Floche/domodin/README.md

# domodin
Extension fil pilote sur rail DIN pour Raspberry Pi

https://domodin.wordpress.com/
