Floche/domodin/hardware/DomoDinV1.0.brd

## EAGLE design hardware/DomoDinV1.0.brd (2015-09-30)

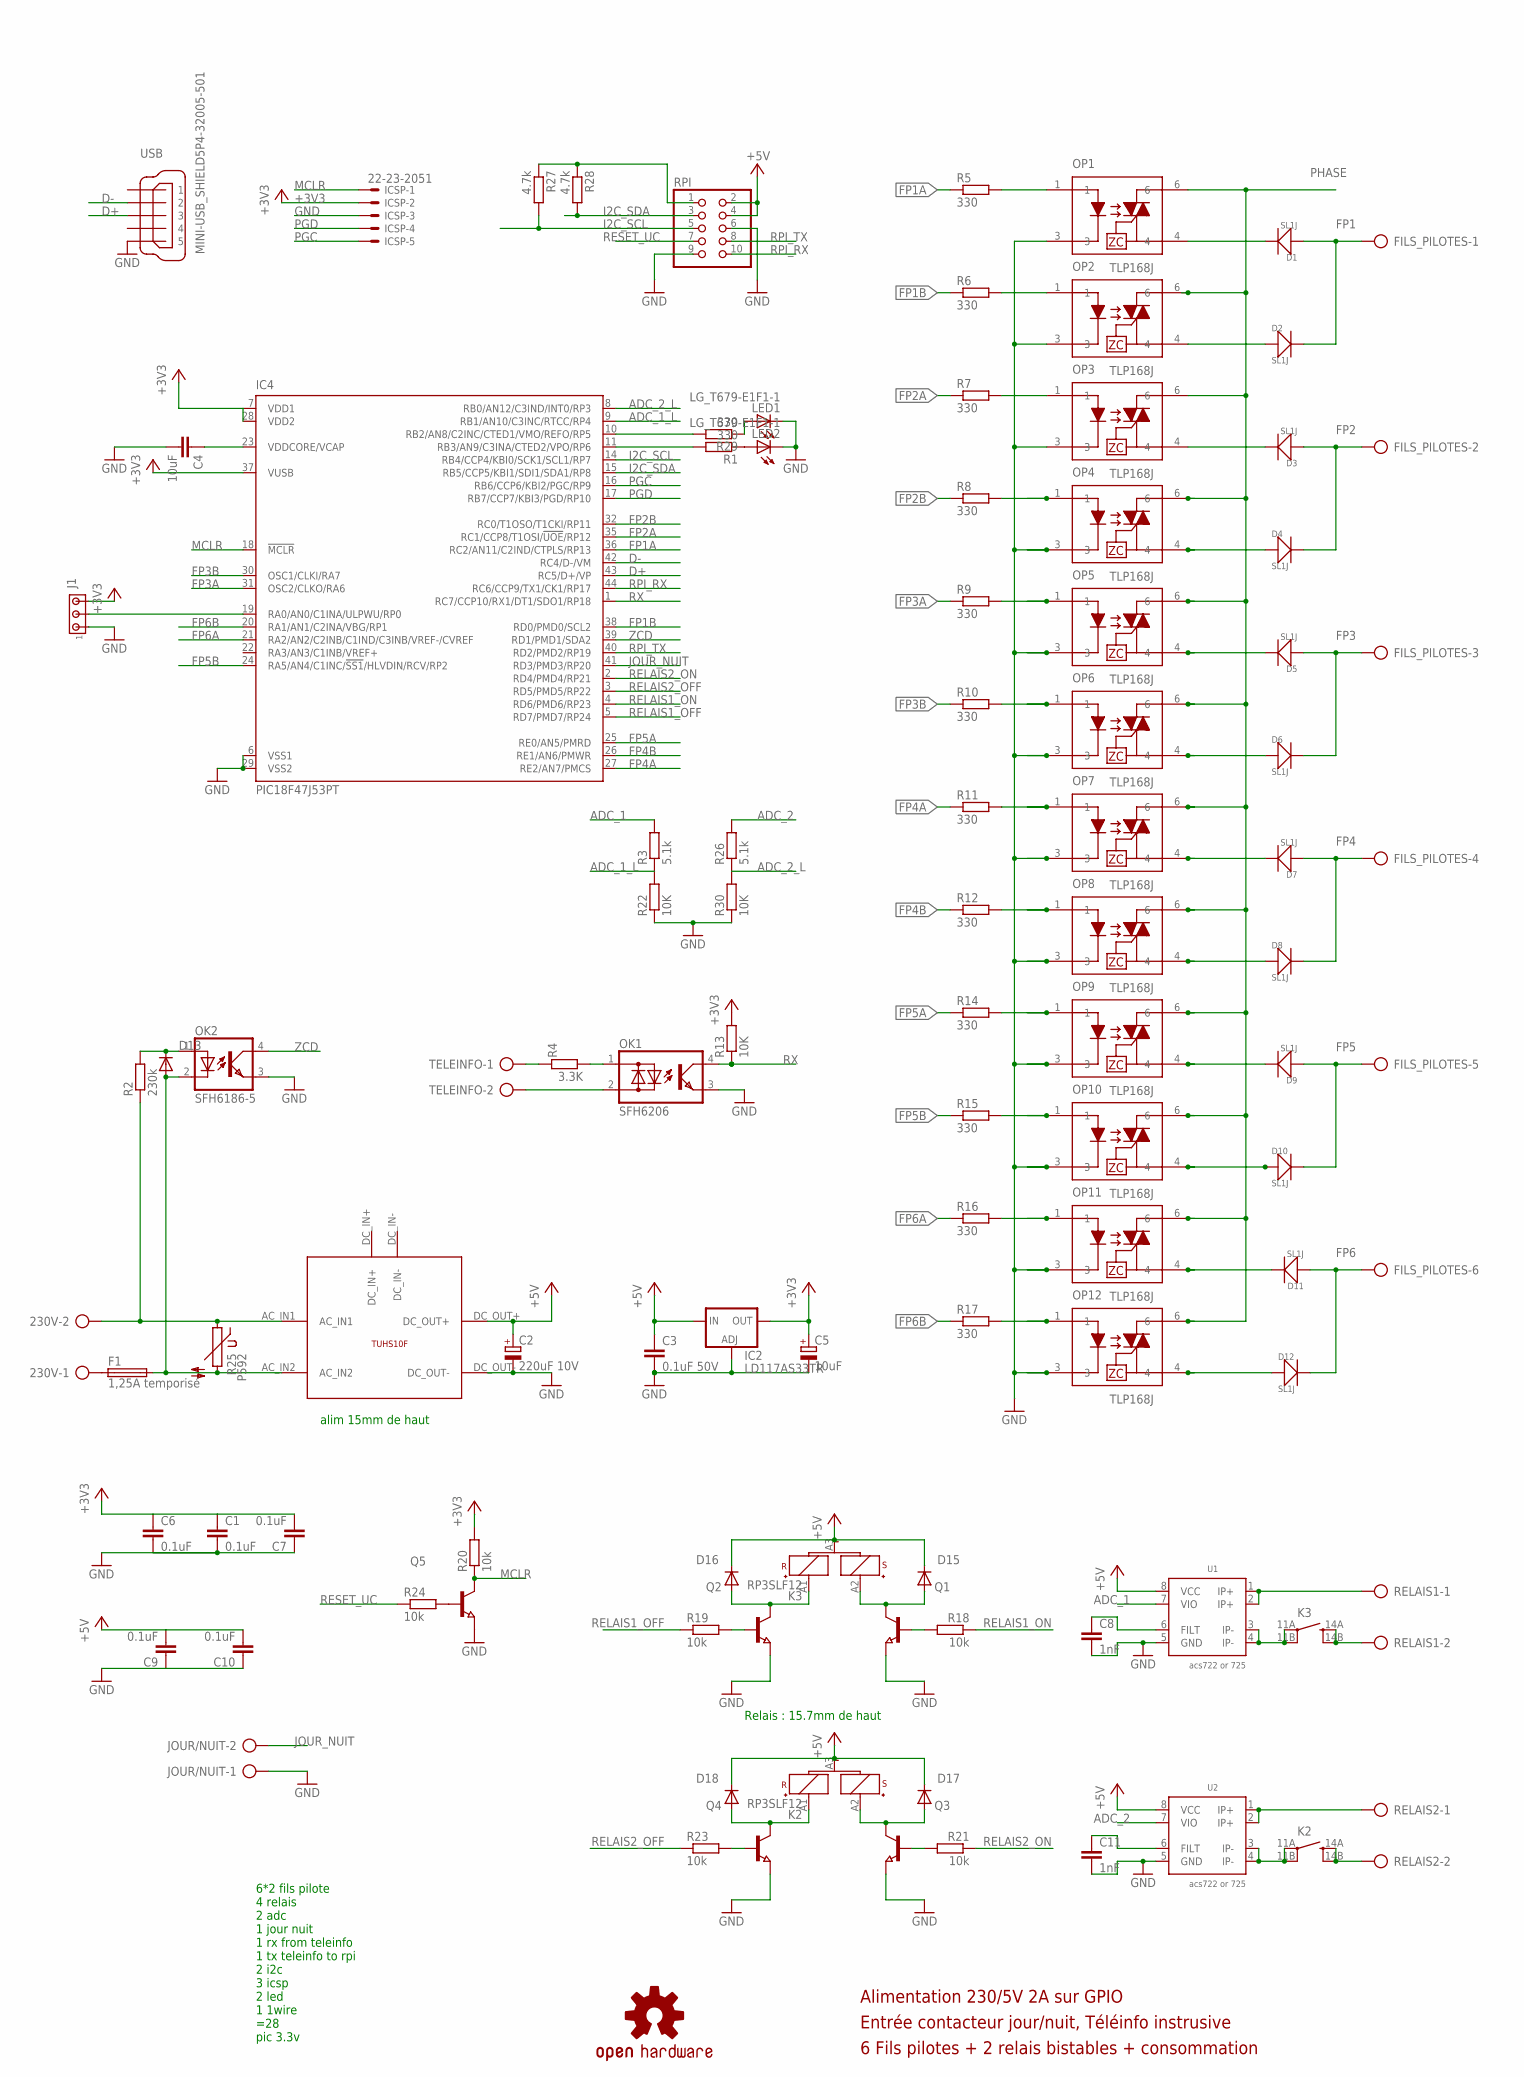
[picture p1: schematic DomoDinV1.0.sch]

Parts:
230V: AK500/2
C1, C6, C7, C9, C10: 0.1uF; C0603
C2: 220uF 10V; E5-8,5
C3: 0.1uF 50V; C1206
C4: 10uF; C1210K
C5: 10uF; C/6032-28R
C8, C11: 1nF; C0402
D1, D2, D3, D4, D5, D6, D7, D8, D9, D10, D11, D12: SL1J; DO-214AC
D13, D15, D16, D17, D18: CGRM4001-G; SOD-123_MINI-SMA
F1: 1,25A temporisé; TE5
FILS_PILOTES: AK500/6
IC2: LD117AS33TR; SOT223
IC4: PIC18F47J53PT; TQFP44
ICSP: 22-23-2051
J1: MTA03-100; 10X03MTA
JOUR/NUIT: AK500/2
K2, K3: RP3SLF12; RP-SLF
LED1, LED2: LG_T679-E1F1-1; PLCC2
LOGO1: OSHW-LOGOL; OSHW-LOGO-L
OK1: SFH6206; DIL4-SMD
OK2: SFH6186-5; SMD4-7
OP1, OP2, OP3, OP4, OP5, OP6, OP7, OP8, OP9, OP10, OP11, OP12: TLP168J; MFSOP-4-HANDSOLDER
Q1, Q2, Q3, Q4, Q5: NPN-TRANSISTOR_SOT23; SOT23
R1, R5, R6, R7, R8, R9, R10, R11, R12, R14, R15, R16, R17, R29: 330; R0805
R2: 230k; 0204/7
R3, R26: 5.1k; R0402
R4: 3.3K; R0805
R13: 10K; R0805
R18, R19, R20, R21, R23, R24: 10k; R0805
R22, R30: 10K; R0402
R25: P592
R27, R28: 4.7k; R0805
RELAIS1, RELAIS2: AK500/2
RPI: PINHD-2X5; 2X05
TELEINFO: AK500/2
U1, U2: acs722 or 725; SO08
U$1: TUHS10F; TUHS10F05
USB: MINI-USB_SHIELD5P4-32005-501; 32005-501

Connections:
+3V3: C1.1, C5.+, C6.1, C7.2, IC2.4 (OUT), IC4.7 (VDD1), IC4.28 (VDD2), IC4.37 (VUSB), ICSP.2, J1.3, R13.2, R20.2
+5V: C2.+, C3.1, C9.2, C10.2, D15.C, D16.C, D17.C, D18.C, IC2.3 (IN), K2.A3 (-), K3.A3 (-), RPI.2, RPI.4, U1.8 (VCC), U2.8 (VCC), U$1.DC_OUT+
ADC_1: R3.2, U1.7 (VIO)
ADC_1_L: IC4.9 (RB1/AN10/C3INC/RTCC/RP4), R3.1, R22.2
ADC_2: R26.2, U2.7 (VIO)
ADC_2_L: IC4.8 (RB0/AN12/C3IND/INT0/RP3), R26.1, R30.2
D+: IC4.43 (RC5/D+/VP), USB.3
D-: IC4.42 (RC4/D-/VM), USB.2
FP1: D1.1 (+), D2.2 (-), FILS_PILOTES.1
FP1A: IC4.36 (RC2/AN11/C2IND/CTPLS/RP13), R5.1
FP1B: IC4.38 (RD0/PMD0/SCL2), R6.1
FP2: D3.1 (+), D4.2 (-), FILS_PILOTES.2
FP2A: IC4.35 (RC1/CCP8/T1OSI/!UOE!/RP12), R7.1
FP2B: IC4.32 (RC0/T1OSO/T1CKI/RP11), R8.1
FP3: D5.1 (+), D6.2 (-), FILS_PILOTES.3
FP3A: IC4.31 (OSC2/CLKO/RA6), R9.1
FP3B: IC4.30 (OSC1/CLKI/RA7), R10.1
FP4: D7.1 (+), D8.2 (-), FILS_PILOTES.4
FP4A: IC4.27 (RE2/AN7/PMCS), R11.1
FP4B: IC4.26 (RE1/AN6/PMWR), R12.1
FP5: D9.1 (+), D10.2 (-), FILS_PILOTES.5
FP5A: IC4.25 (RE0/AN5/PMRD), R14.1
FP5B: IC4.24 (RA5/AN4/C1INC/!SS1!/HLVDIN/RCV/RP2), R15.1
FP6: D11.1 (+), D12.2 (-), FILS_PILOTES.6
FP6A: IC4.21 (RA2/AN2/C2INB/C1IND/C3INB/VREF-/CVREF), R16.1
FP6B: IC4.20 (RA1/AN1/C2INA/VBG/RP1), R17.1
GND: C1.2, C2.-, C3.2, C4.2, C5.-, C6.2, C7.1, C8.2, C9.1, C10.1, C11.2, IC2.1 (ADJ), IC4.6 (VSS1), IC4.29 (VSS2), ICSP.3, J1.1, JOUR/NUIT.1, LED1.C, LED2.C, OK1.3 (E), OK2.3 (EMIT), OP1.3, OP2.3, OP3.3, OP4.3, OP5.3, OP6.3, OP7.3, OP8.3, OP9.3, OP10.3, OP11.3, OP12.3, Q1.2 (E), Q2.2 (E), Q3.2 (E), Q4.2 (E), Q5.2 (E), R22.1, R30.1, RPI.6, RPI.9, U1.5 (GND), U2.5 (GND), U$1.DC_OUT-, USB.5
I2C_SCL: IC4.14 (RB4/CCP4/KBI0/SCK1/SCL1/RP7), R27.2, RPI.5
I2C_SDA: IC4.15 (RB5/CCP5/KBI1/SDI1/SDA1/RP8), R28.2, RPI.3
JOUR_NUIT: IC4.41 (RD3/PMD3/RP20), JOUR/NUIT.2
MCLR: IC4.18 (!MCLR), ICSP.1, Q5.3 (C), R20.1
unnamed: R4.1, TELEINFO.1
unnamed: OK1.2 (AC2), TELEINFO.2
unnamed: RELAIS1.1, U1.1 (IP+), U1.2 (IP+)
unnamed: IC4.10 (RB2/AN8/C2INC/CTED1/VMO/REFO/RP5), R29.2
unnamed: OK1.1 (AC1), R4.2
unnamed: K2.11A (PA), K2.11B (PB), U2.3 (IP-), U2.4 (IP-)
unnamed: OP1.1, R5.2
unnamed: OP2.1, R6.2
unnamed: D1.2 (-), OP1.4
unnamed: OP3.1, R7.2
unnamed: OP5.1, R9.2
unnamed: OP6.1, R10.2
unnamed: OP7.1, R11.2
unnamed: OP8.1, R12.2
unnamed: OP4.1, R8.2
unnamed: D2.1 (+), OP2.4
unnamed: 230V.1, F1.1
unnamed: K3.11A (PA), K3.11B (PB), U1.3 (IP-), U1.4 (IP-)
unnamed: OP9.1, R14.2
unnamed: K3.14A (SA), K3.14B (SB), RELAIS1.2
unnamed: Q1.1 (B), R18.2
unnamed: D3.2 (-), OP3.4
unnamed: LED2.A, R1.1
unnamed: D5.2 (-), OP5.4
unnamed: D4.1 (+), OP4.4
unnamed: D7.2 (-), OP7.4
unnamed: K2.14A (SA), K2.14B (SB), RELAIS2.2
unnamed: D15.A, K3.A2 (S+), Q1.3 (C)
unnamed: D6.1 (+), OP6.4
unnamed: Q2.1 (B), R19.2
unnamed: D8.1 (+), OP8.4
unnamed: OP10.1, R15.2
unnamed: D16.A, K3.A1 (R+), Q2.3 (C)
unnamed: Q3.1 (B), R21.2
unnamed: D17.A, K2.A2 (S+), Q3.3 (C)
unnamed: Q4.1 (B), R23.2
unnamed: D18.A, K2.A1 (R+), Q4.3 (C)
unnamed: 230V.2, R2.1, R25.1, U$1.AC_IN1
unnamed: C4.1, IC4.23 (VDDCORE/VCAP)
unnamed: RELAIS2.1, U2.1 (IP+), U2.2 (IP+)
unnamed: Q5.1 (B), R24.2
unnamed: D9.2 (-), OP9.4
unnamed: IC4.11 (RB3/AN9/C3INA/CTED2/VPO/RP6), R1.2
unnamed: LED1.A, R29.1
unnamed: IC4.19 (RA0/AN0/C1INA/ULPWU/RP0), J1.2
unnamed: OP11.1, R16.2
unnamed: OP12.1, R17.2
unnamed: D10.1 (+), OP10.4
unnamed: R27.1, R28.1, RPI.1
unnamed: D12.1 (+), OP12.4
unnamed: C11.1, U2.6 (FILT)
unnamed: D13.C, OK2.1 (A), R2.2
unnamed: C8.1, U1.6 (FILT)
PGC: IC4.16 (RB6/CCP6/KBI2/PGC/RP9), ICSP.5
PGD: IC4.17 (RB7/CCP7/KBI3/PGD/RP10), ICSP.4
PHASE: D13.A, F1.2, OK2.2 (C), OP1.6, OP2.6, OP3.6, OP4.6, OP5.6, OP6.6, OP7.6, OP8.6, OP9.6, OP10.6, OP11.6, OP12.6, R25.2, U$1.AC_IN2
RELAIS1_OFF: IC4.5 (RD7/PMD7/RP24), R19.1
RELAIS1_ON: IC4.4 (RD6/PMD6/RP23), R18.1
RELAIS2_OFF: IC4.3 (RD5/PMD5/RP22), R23.1
RELAIS2_ON: IC4.2 (RD4/PMD4/RP21), R21.1
RESET_UC: R24.1, RPI.7
RPI_RX: IC4.44 (RC6/CCP9/TX1/CK1/RP17), RPI.10
RPI_TX: IC4.40 (RD2/PMD2/RP19), RPI.8
RX: IC4.1 (RC7/CCP10/RX1/DT1/SDO1/RP18), OK1.4 (C), R13.1
S$1: D11.2 (-), OP11.4
ZCD: IC4.39 (RD1/PMD1/SDA2), OK2.4 (COL)

Notes on the sheet:
6 Fils pilotes + 2 relais bistables + consommation
Entrée contacteur jour/nuit, Téléinfo instrusive
Alimentation 230/5V 2A sur GPIO
6*2 fils pilote 4 relais 2 adc 1 jour nuit 1 rx from teleinfo 1 tx teleinfo to rpi 2 i2c 3 icsp 2 led 1 1wire =28 pic 3.3v
alim 15mm de haut
Relais : 15.7mm de haut

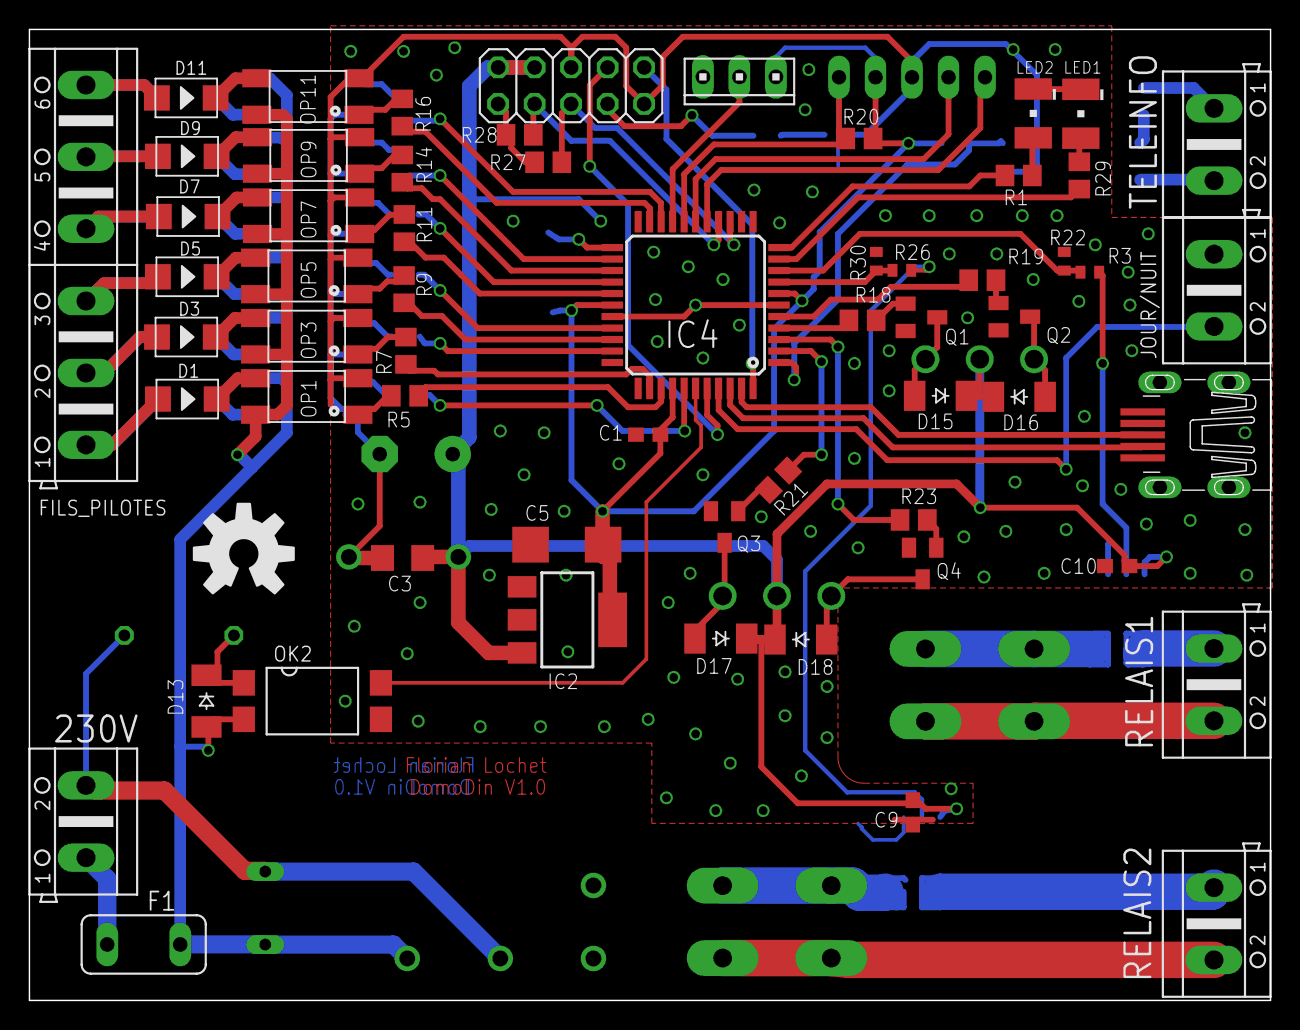
[picture p2: board DomoDinV1.0.brd from above]

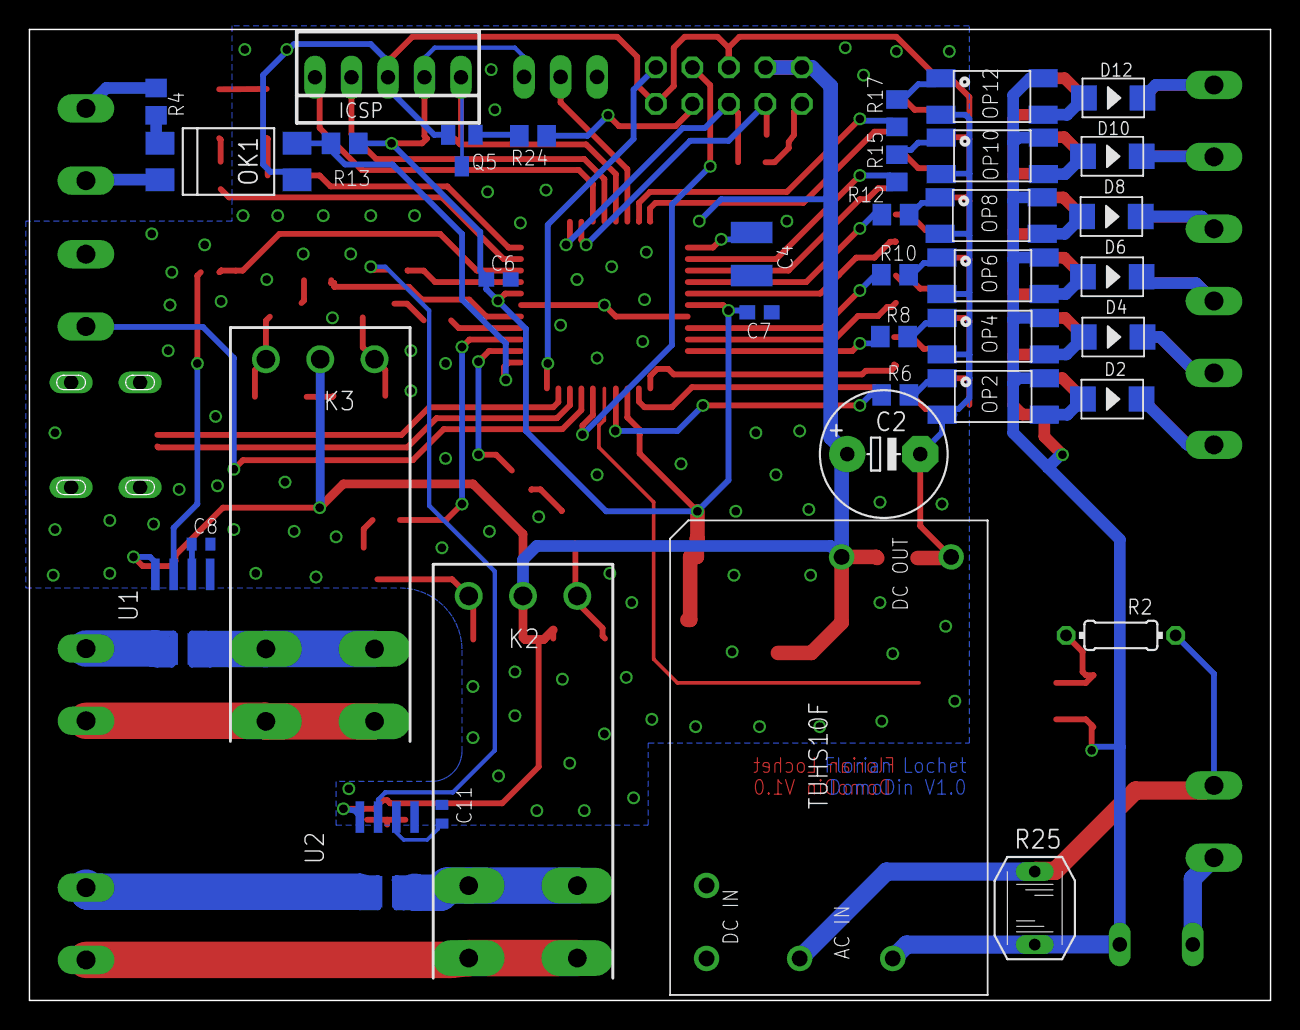
[picture p3: board DomoDinV1.0.brd from below]

Board: 2 copper layers, 86.4 x 67.6 mm, 98 parts (37 on the bottom side), 97 nets.
