Floche/domodin/firmware/hardware.h

#ifndef HARDWARE_H
#define	HARDWARE_H

#define LED1 	PIN_B2
#define LED2 	PIN_B3

#define FP1A    PIN_C2
#define FP1B    PIN_D0
#define FP2A    PIN_C1
#define FP2B    PIN_C0
#define FP3A    PIN_A6
#define FP3B    PIN_A7
#define FP4A    PIN_E2
#define FP4B    PIN_E1
#define FP5A    PIN_E0
#define FP5B    PIN_A5
#define FP6A    PIN_A2
#define FP6B    PIN_A1

#define RELAIS1_ON  PIN_D6
#define RELAIS1_OFF PIN_D7
#define RELAIS1_ADC	10

#define RELAIS2_ON  PIN_D4
#define RELAIS2_OFF PIN_D5
#define RELAIS2_ADC	12

#define DELAIS_RELAIS_MS 30

#define ONE_WIRE        PIN_A0
#define ZCD             PIN_D1
#define CONTACT_IO      PIN_D3
#define SERIAL_FROM_RPI PIN_D2

#define ADC_RELAIS_1    
#define ADC_RELAIS_2    

#endif	/* HARDWARE_H */
