Floche/domodin/(commit log)

2015-09-30 Adding schematic and bootloader
    [DomoDinV1.0.brd, DomoDinV1.0.sch]
2015-10-13 Removal of current order
2015-10-13 Adding ADC measure
2015-11-18 Current measure working
    Correcting ADC reading.
    Adding average and maximum detection
    [hardware.h, main.c, main.h, outputs.c]
